pfoff/m0116_usb-/firmware/qmk/readme.md

# M0116 USB

m0116_usb

**[Deutsch](#deutsch) | [English](#english)**

## Deutsch

Drop-in-Ersatzplatine für den Apple M0116

* Keyboard-Maintainer: [elmo-space](https://github.com/elmo-space)
* Unterstützte Hardware: M0116 USB
* Verfügbarkeit der Hardware: [Das Projekt ist Open Source](https://github.com/elmo-space/m0116_usb)

Beispiel-Build für diese Tastatur (nachdem die Build-Umgebung eingerichtet ist):

    make kb_elmo/m0116_usb:default

Weitere Informationen: [Einrichtung der Build-Umgebung](https://docs.qmk.fm/#/getting_started_build_tools) und [Make-Anleitung](https://docs.qmk.fm/#/getting_started_make_guide). Ganz neu bei QMK? Am besten mit dem [Complete Newbs Guide](https://docs.qmk.fm/#/newbs) anfangen.

Hinweis: Diese QMK-Firmware gehört zum ursprünglichen ATmega32A-Design. Die
Wireless-TrackPoint-Revision (Branch `wireless-trackpoint`) verwendet einen
nice!nano v2 mit ZMK.

## English

Drop in replacement PCB for the Apple M0116

* Keyboard Maintainer: [elmo-space](https://github.com/elmo-space)
* Hardware Supported: M0116 USB
* Hardware Availability: [Project is open source](https://github.com/elmo-space/m0116_usb)

Make example for this keyboard (after setting up your build environment):

    make kb_elmo/m0116_usb:default

See the [build environment setup](https://docs.qmk.fm/#/getting_started_build_tools) and the [make instructions](https://docs.qmk.fm/#/getting_started_make_guide) for more information. Brand new to QMK? Start with our [Complete Newbs Guide](https://docs.qmk.fm/#/newbs).

Note: this QMK firmware belongs to the original ATmega32A design. The
wireless TrackPoint revision (branch `wireless-trackpoint`) uses a
nice!nano v2 running ZMK.
