pfoff/m0116_usb-/m0116_tkl.kicad_pcb

## KiCad design m0116_tkl.kicad_pcb (2026-10-25)

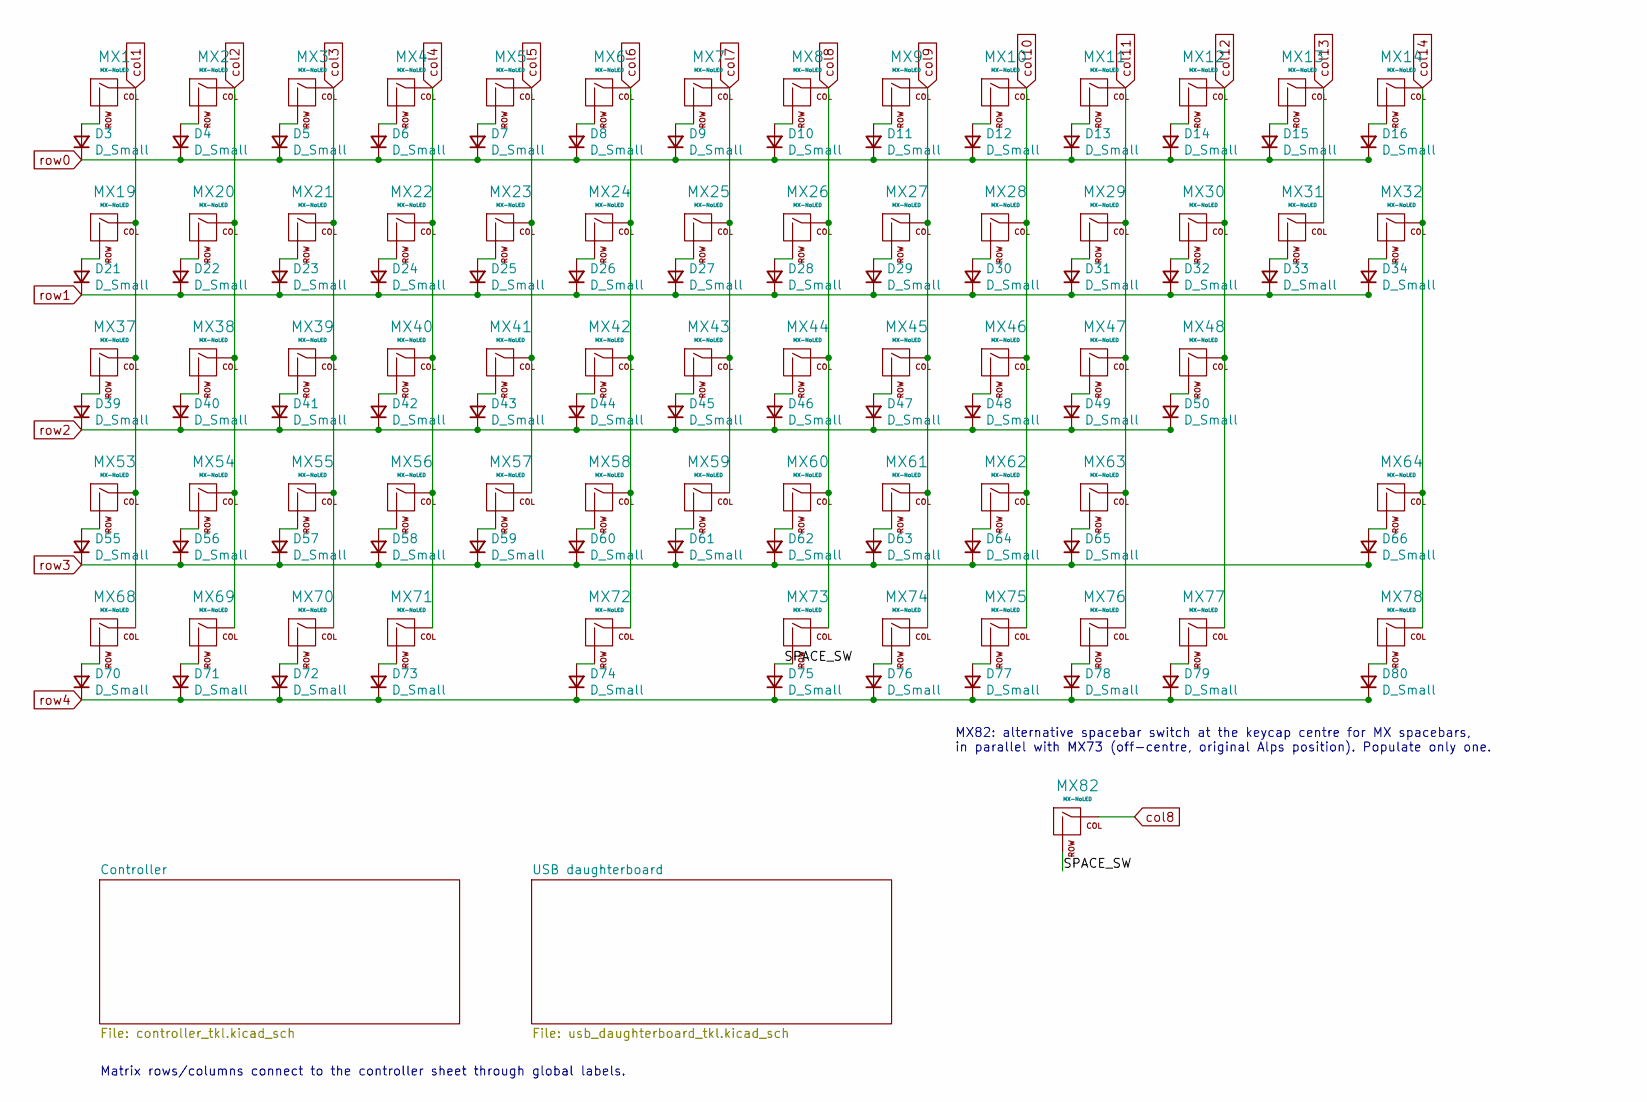
[picture p1: schematic m0116_tkl.kicad_sch]

Parts:
D3, D4, D5, D6, D7, D8, D9, D10, D11, D12, D13, D14, D15, D16, D21, D22, D23, D24, D25, D26, D27, D28, D29, D30, D31, D32, D33, D34, D39, D40, D41, D42, D43, D44, D45, D46, D47, D48, D49, D50, D55, D56, D57, D58, D59, D60, D61, D62, D63, D64, D65, D66, D70, D71, D72, D73, D74, D75, D76, D77, D78, D79, D80: D_Small; D_DO-35_SOD27_P7.62mm_Horizontal
MX1, MX2, MX3, MX4, MX5, MX6, MX7, MX8, MX9, MX10, MX11, MX12, MX13, MX14, MX19, MX20, MX21, MX22, MX23, MX24, MX25, MX26, MX27, MX28, MX29, MX30, MX31, MX32, MX37, MX38, MX39, MX40, MX41, MX42, MX43, MX44, MX45, MX46, MX47, MX48, MX53, MX54, MX55, MX56, MX57, MX58, MX59, MX60, MX61, MX62, MX63, MX64, MX68, MX69, MX70, MX71, MX72, MX73, MX74, MX75, MX76, MX77, MX78, MX82: MX-NoLED; MX-1U-NoLED

Connections:
/SPACE_SW: D75.2 (A), MX73.2 (ROW), MX82.2 (ROW)
unnamed: D3.2 (A), MX1.2 (ROW)
unnamed: D4.2 (A), MX2.2 (ROW)
unnamed: D5.2 (A), MX3.2 (ROW)
unnamed: D6.2 (A), MX4.2 (ROW)
unnamed: D7.2 (A), MX5.2 (ROW)
unnamed: D8.2 (A), MX6.2 (ROW)
unnamed: D9.2 (A), MX7.2 (ROW)
unnamed: D10.2 (A), MX8.2 (ROW)
unnamed: D11.2 (A), MX9.2 (ROW)
unnamed: D12.2 (A), MX10.2 (ROW)
unnamed: D13.2 (A), MX11.2 (ROW)
unnamed: D14.2 (A), MX12.2 (ROW)
unnamed: D15.2 (A), MX13.2 (ROW)
unnamed: D16.2 (A), MX14.2 (ROW)
unnamed: D21.2 (A), MX19.2 (ROW)
unnamed: D22.2 (A), MX20.2 (ROW)
unnamed: D23.2 (A), MX21.2 (ROW)
unnamed: D24.2 (A), MX22.2 (ROW)
unnamed: D25.2 (A), MX23.2 (ROW)
unnamed: D26.2 (A), MX24.2 (ROW)
unnamed: D27.2 (A), MX25.2 (ROW)
unnamed: D28.2 (A), MX26.2 (ROW)
unnamed: D29.2 (A), MX27.2 (ROW)
unnamed: D30.2 (A), MX28.2 (ROW)
unnamed: D31.2 (A), MX29.2 (ROW)
unnamed: D32.2 (A), MX30.2 (ROW)
unnamed: D33.2 (A), MX31.2 (ROW)
unnamed: D34.2 (A), MX32.2 (ROW)
unnamed: D39.2 (A), MX37.2 (ROW)
unnamed: D40.2 (A), MX38.2 (ROW)
unnamed: D41.2 (A), MX39.2 (ROW)
unnamed: D42.2 (A), MX40.2 (ROW)
unnamed: D43.2 (A), MX41.2 (ROW)
unnamed: D44.2 (A), MX42.2 (ROW)
unnamed: D45.2 (A), MX43.2 (ROW)
unnamed: D46.2 (A), MX44.2 (ROW)
unnamed: D47.2 (A), MX45.2 (ROW)
unnamed: D48.2 (A), MX46.2 (ROW)
unnamed: D49.2 (A), MX47.2 (ROW)
unnamed: D50.2 (A), MX48.2 (ROW)
unnamed: D55.2 (A), MX53.2 (ROW)
unnamed: D56.2 (A), MX54.2 (ROW)
unnamed: D57.2 (A), MX55.2 (ROW)
unnamed: D58.2 (A), MX56.2 (ROW)
unnamed: D59.2 (A), MX57.2 (ROW)
unnamed: D60.2 (A), MX58.2 (ROW)
unnamed: D61.2 (A), MX59.2 (ROW)
unnamed: D62.2 (A), MX60.2 (ROW)
unnamed: D63.2 (A), MX61.2 (ROW)
unnamed: D64.2 (A), MX62.2 (ROW)
unnamed: D65.2 (A), MX63.2 (ROW)
unnamed: D66.2 (A), MX64.2 (ROW)
unnamed: D70.2 (A), MX68.2 (ROW)
unnamed: D71.2 (A), MX69.2 (ROW)
unnamed: D72.2 (A), MX70.2 (ROW)
unnamed: D73.2 (A), MX71.2 (ROW)
unnamed: D74.2 (A), MX72.2 (ROW)
unnamed: D76.2 (A), MX74.2 (ROW)
unnamed: D77.2 (A), MX75.2 (ROW)
unnamed: D78.2 (A), MX76.2 (ROW)
unnamed: D79.2 (A), MX77.2 (ROW)
unnamed: D80.2 (A), MX78.2 (ROW)
col1: MX1.1 (COL), MX19.1 (COL), MX37.1 (COL), MX53.1 (COL), MX68.1 (COL); also elsewhere on the board
col2: MX2.1 (COL), MX20.1 (COL), MX38.1 (COL), MX54.1 (COL), MX69.1 (COL); also elsewhere on the board
col3: MX3.1 (COL), MX21.1 (COL), MX39.1 (COL), MX55.1 (COL), MX70.1 (COL); also elsewhere on the board
col4: MX4.1 (COL), MX22.1 (COL), MX40.1 (COL), MX56.1 (COL), MX71.1 (COL); also elsewhere on the board
col5: MX5.1 (COL), MX23.1 (COL), MX41.1 (COL), MX57.1 (COL); also elsewhere on the board
col6: MX6.1 (COL), MX24.1 (COL), MX42.1 (COL), MX58.1 (COL), MX72.1 (COL); also elsewhere on the board
col7: MX7.1 (COL), MX25.1 (COL), MX43.1 (COL), MX59.1 (COL); also elsewhere on the board
col8: MX8.1 (COL), MX26.1 (COL), MX44.1 (COL), MX60.1 (COL), MX73.1 (COL), MX82.1 (COL); also elsewhere on the board
col9: MX9.1 (COL), MX27.1 (COL), MX45.1 (COL), MX61.1 (COL), MX74.1 (COL); also elsewhere on the board
col10: MX10.1 (COL), MX28.1 (COL), MX46.1 (COL), MX62.1 (COL), MX75.1 (COL); also elsewhere on the board
col11: MX11.1 (COL), MX29.1 (COL), MX47.1 (COL), MX63.1 (COL), MX76.1 (COL); also elsewhere on the board
col12: MX12.1 (COL), MX30.1 (COL), MX48.1 (COL), MX77.1 (COL); also elsewhere on the board
col13: MX13.1 (COL), MX31.1 (COL); also elsewhere on the board
col14: MX14.1 (COL), MX32.1 (COL), MX64.1 (COL), MX78.1 (COL); also elsewhere on the board
row0: D3.1 (K), D4.1 (K), D5.1 (K), D6.1 (K), D7.1 (K), D8.1 (K), D9.1 (K), D10.1 (K), D11.1 (K), D12.1 (K), D13.1 (K), D14.1 (K), D15.1 (K), D16.1 (K); also elsewhere on the board
row1: D21.1 (K), D22.1 (K), D23.1 (K), D24.1 (K), D25.1 (K), D26.1 (K), D27.1 (K), D28.1 (K), D29.1 (K), D30.1 (K), D31.1 (K), D32.1 (K), D33.1 (K), D34.1 (K); also elsewhere on the board
row2: D39.1 (K), D40.1 (K), D41.1 (K), D42.1 (K), D43.1 (K), D44.1 (K), D45.1 (K), D46.1 (K), D47.1 (K), D48.1 (K), D49.1 (K), D50.1 (K); also elsewhere on the board
row3: D55.1 (K), D56.1 (K), D57.1 (K), D58.1 (K), D59.1 (K), D60.1 (K), D61.1 (K), D62.1 (K), D63.1 (K), D64.1 (K), D65.1 (K), D66.1 (K); also elsewhere on the board
row4: D70.1 (K), D71.1 (K), D72.1 (K), D73.1 (K), D74.1 (K), D75.1 (K), D76.1 (K), D77.1 (K), D78.1 (K), D79.1 (K), D80.1 (K); also elsewhere on the board

Notes on the sheet:
Matrix rows/columns connect to the controller sheet through global labels.
MX82: alternative spacebar switch at the keycap centre for MX spacebars, in parallel with MX73 (off-centre, original Alps position). Populate only one.

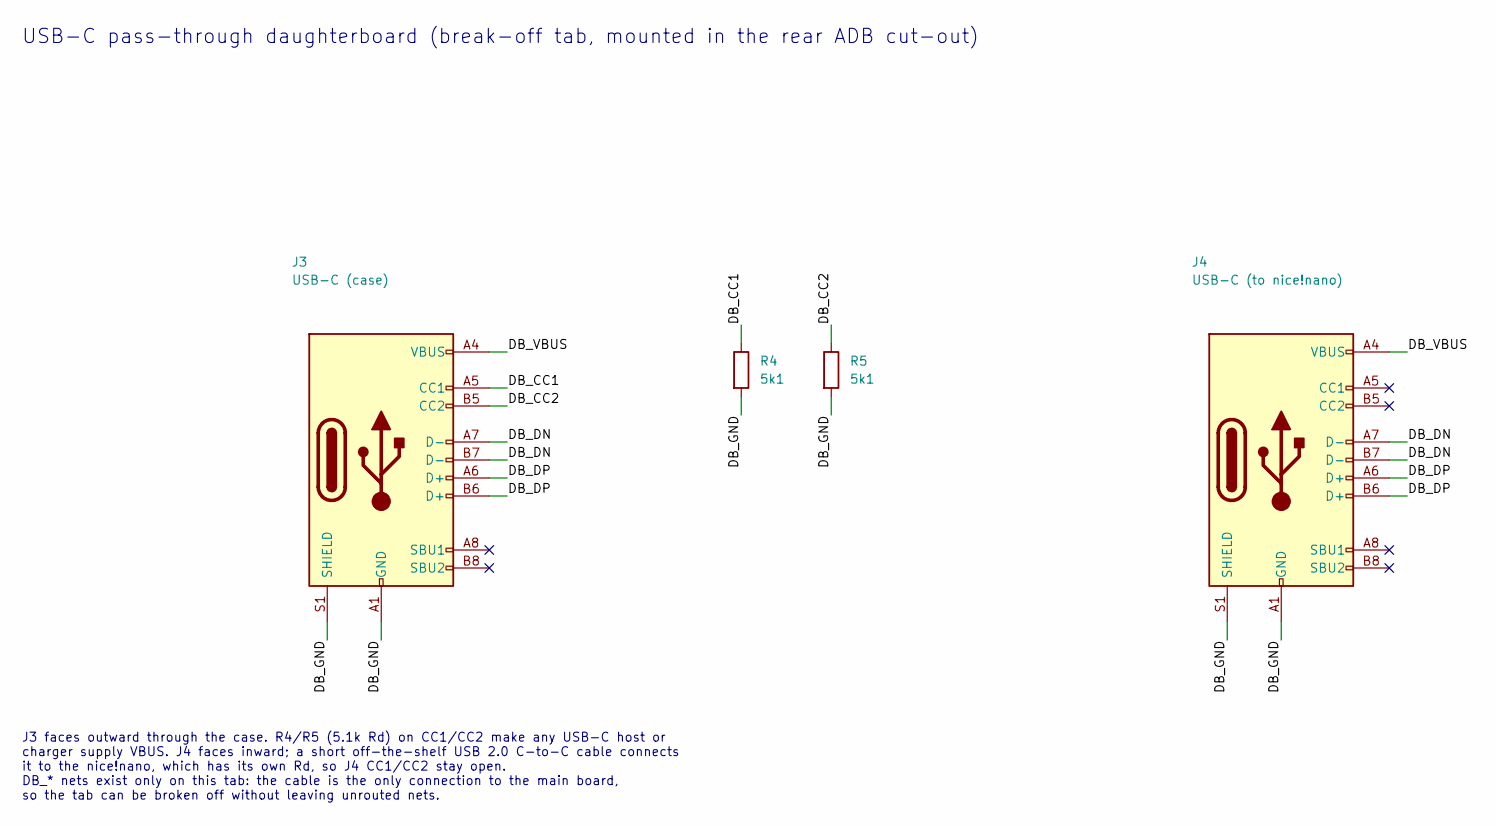
[picture p2: schematic usb_daughterboard_tkl.kicad_sch, M0116 wireless TrackPoint - USB-C daughterboard]

Parts:
J3: USB-C (case); USB_C_Receptacle_GCT_USB4085
J4: USB-C (to nice!nano); USB_C_Receptacle_GCT_USB4085
R4, R5: 5k1; R_Axial_DIN0207_L6.3mm_D2.5mm_P2.54mm_Vertical

Connections:
/USB daughterboard/DB_CC1: J3.A5 (CC1), R4.1
/USB daughterboard/DB_CC2: J3.B5 (CC2), R5.1
/USB daughterboard/DB_DN: J3.A7 (D-), J3.B7 (D-), J4.A7 (D-), J4.B7 (D-)
/USB daughterboard/DB_DP: J3.A6 (D+), J3.B6 (D+), J4.A6 (D+), J4.B6 (D+)
/USB daughterboard/DB_GND: J3.A1 (GND), J3.A12 (GND), J3.B1 (GND), J3.B12 (GND), J3.S1 (SHIELD), J4.A1 (GND), J4.A12 (GND), J4.B1 (GND), J4.B12 (GND), J4.S1 (SHIELD), R4.2, R5.2
/USB daughterboard/DB_VBUS: J3.A4 (VBUS), J3.A9 (VBUS), J3.B4 (VBUS), J3.B9 (VBUS), J4.A4 (VBUS), J4.A9 (VBUS), J4.B4 (VBUS), J4.B9 (VBUS)

Notes on the sheet:
USB-C pass-through daughterboard (break-off tab, mounted in the rear ADB cut-out)
J3 faces outward through the case. R4/R5 (5.1k Rd) on CC1/CC2 make any USB-C host or charger supply VBUS. J4 faces inward; a short off-the-shelf USB 2.0 C-to-C cable connects it to the nice!nano, which has its own Rd, so J4 CC1/CC2 stay open. DB_* nets exist only on this tab: the cable is the only 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

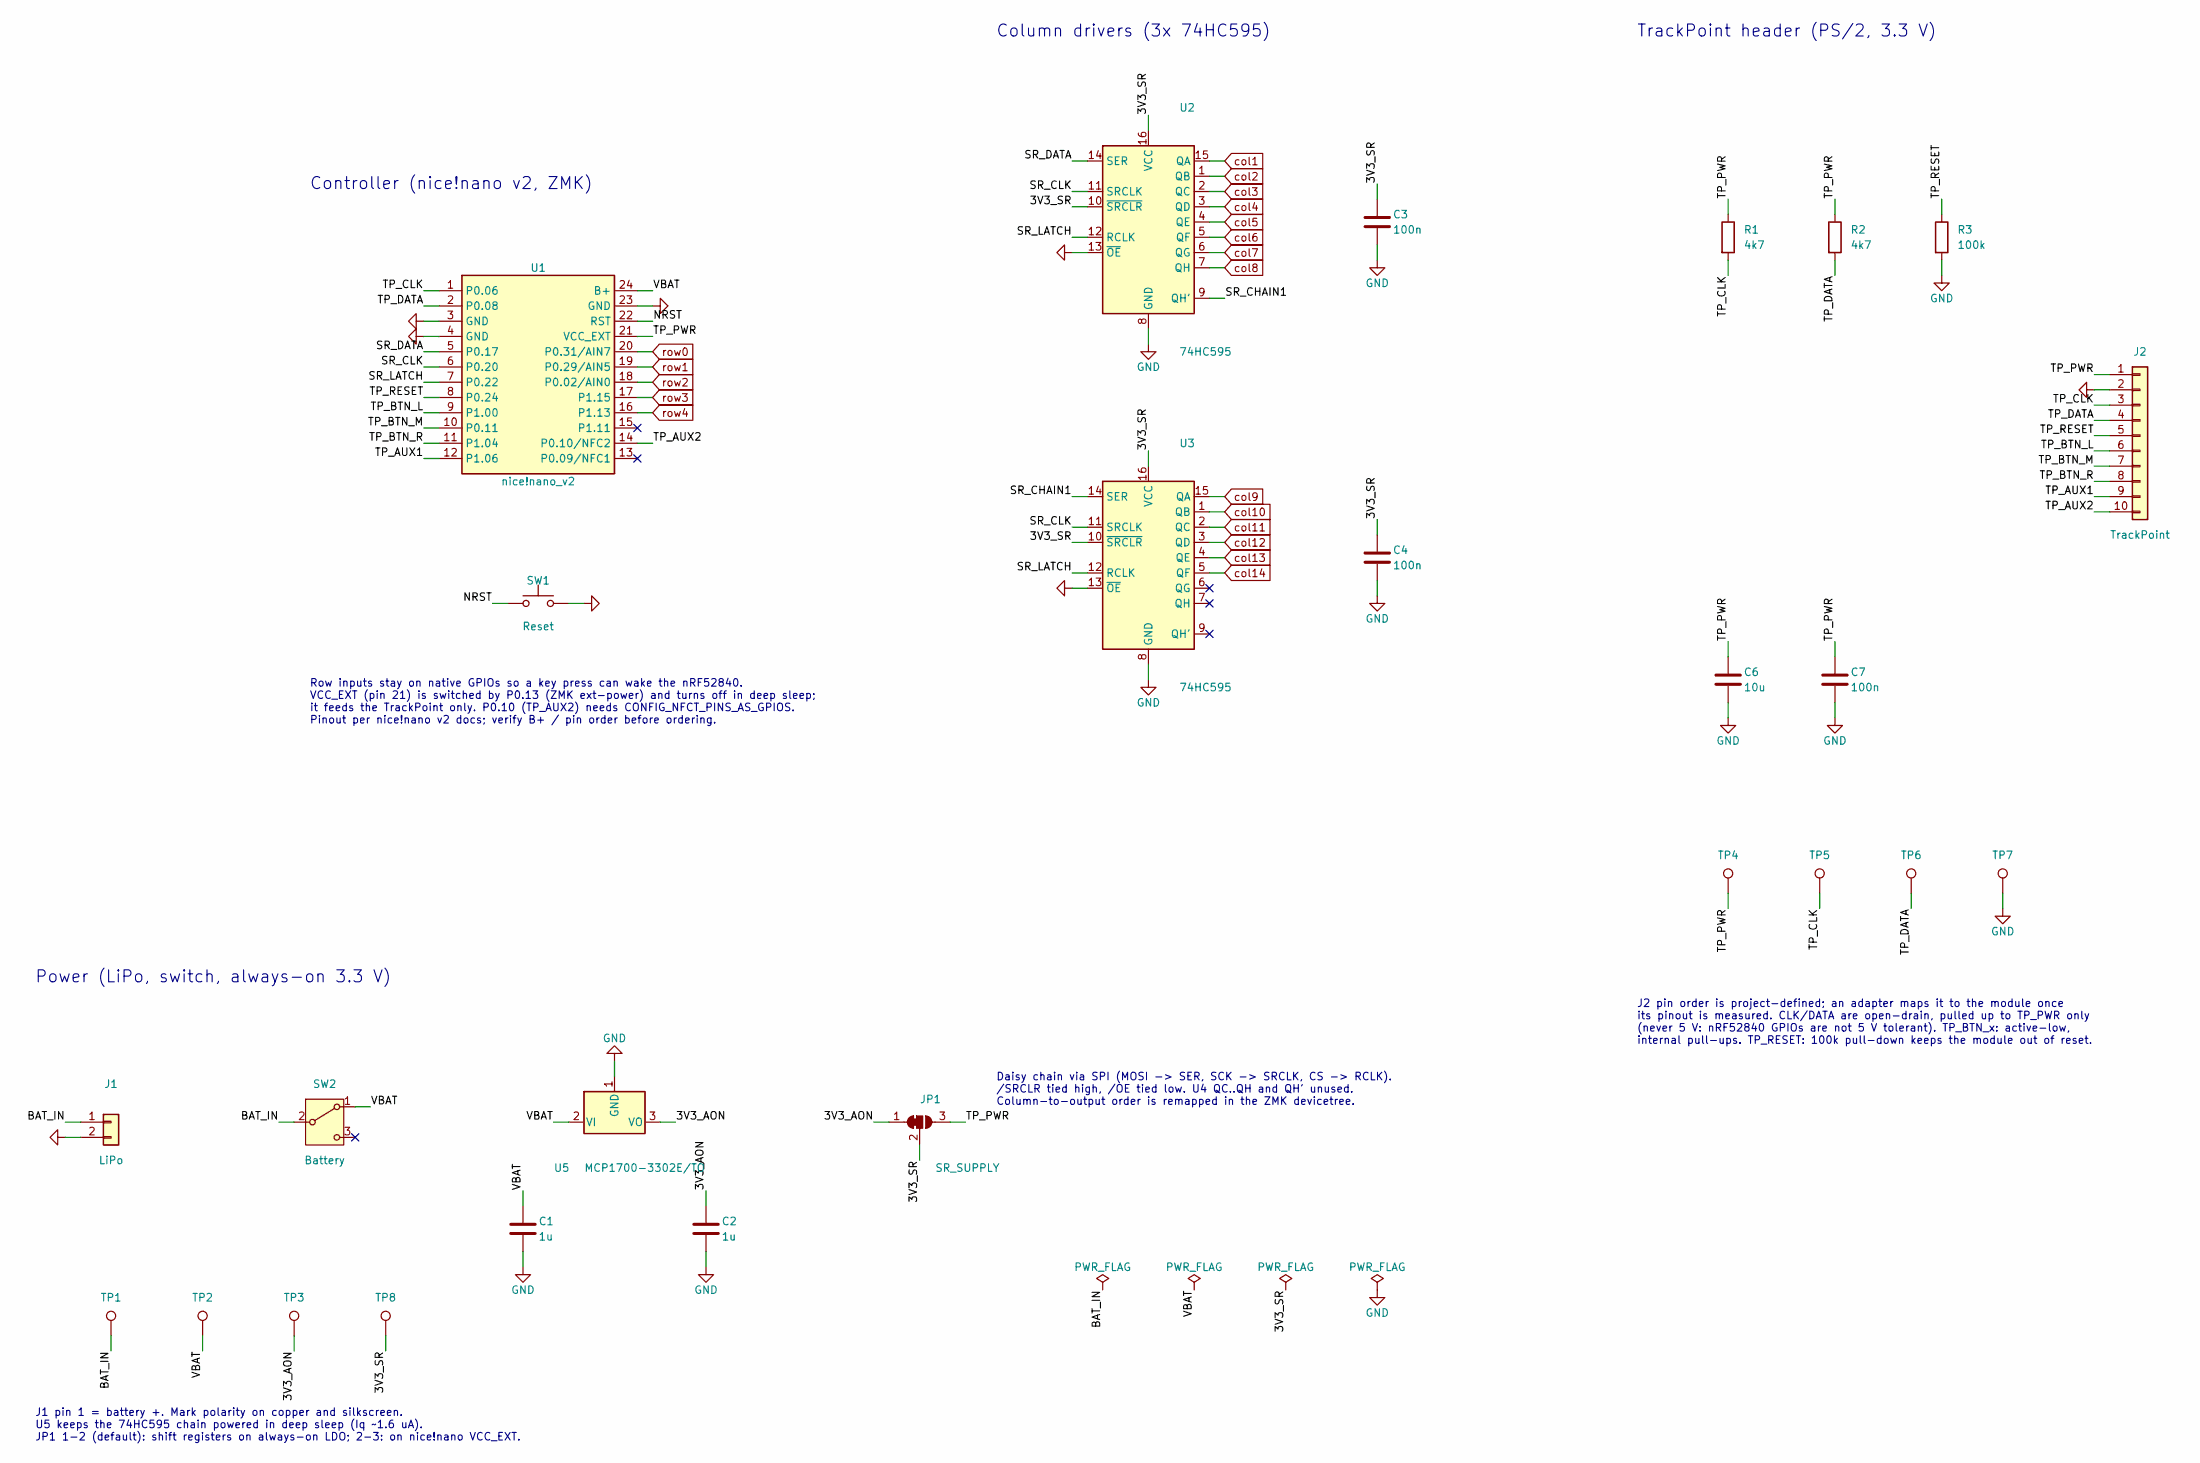
[picture p3: schematic controller_tkl.kicad_sch, M0116 wireless TrackPoint - controller]

Parts:
C1, C2: 1u; C_Disc_D3.0mm_W2.0mm_P2.50mm
C3, C4, C7: 100n; C_Disc_D3.0mm_W2.0mm_P2.50mm
C6: 10u; C_Disc_D5.0mm_W2.5mm_P5.00mm
J1: LiPo; JST_PH_S2B-PH-K_1x02_P2.00mm_Horizontal
J2: TrackPoint; PinHeader_1x10_P2.54mm_Vertical
JP1: SR_SUPPLY; SolderJumper-3_P1.3mm_Bridged12_RoundedPad1.0x1.5mm_NumberL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
R1, R2: 4k7; R_Axial_DIN0207_L6.3mm_D2.5mm_P10.16mm_Horizontal
R3: 100k; R_Axial_DIN0207_L6.3mm_D2.5mm_P10.16mm_Horizontal
SW1: Reset; SW_PUSH_6mm
SW2: Battery; SW_Slide_SPDT_Angled_CK_OS102011MA1Q
TP1: BAT_IN; TestPoint_THTPad_D1.5mm_Drill0.7mm
TP2: VBAT; TestPoint_THTPad_D1.5mm_Drill0.7mm
TP3: 3V3_AON; TestPoint_THTPad_D1.5mm_Drill0.7mm
TP4: TP_PWR; TestPoint_THTPad_D1.5mm_Drill0.7mm
TP5: TP_CLK; TestPoint_THTPad_D1.5mm_Drill0.7mm
TP6: TP_DATA; TestPoint_THTPad_D1.5mm_Drill0.7mm
TP7: GND; TestPoint_THTPad_D1.5mm_Drill0.7mm
TP8: 3V3_SR; TestPoint_THTPad_D1.5mm_Drill0.7mm
U1: nice!nano_v2; DIP-24_W15.24mm_Socket
U2, U3: 74HC595; DIP-16_W7.62mm_Socket
U5: MCP1700-3302E/TO; TO-92_Inline

Connections:
/Controller/3V3_AON: C2.1, JP1.1 (A), TP3.1, U5.3 (VO)
/Controller/3V3_SR: C3.1, C4.1, JP1.2 (C), TP8.1, U2.10 (~SRCLR), U2.16 (VCC), U3.10 (~SRCLR), U3.16 (VCC)
/Controller/BAT_IN: J1.1, SW2.2 (B), TP1.1
/Controller/NRST: SW1.1, U1.22 (RST)
/Controller/SR_CHAIN1: U2.9 (QH'), U3.14 (SER)
/Controller/SR_CLK: U1.6 (P0.20), U2.11 (SRCLK), U3.11 (SRCLK)
/Controller/SR_DATA: U1.5 (P0.17), U2.14 (SER)
/Controller/SR_LATCH: U1.7 (P0.22), U2.12 (RCLK), U3.12 (RCLK)
/Controller/TP_AUX1: J2.9, U1.12 (P1.06)
/Controller/TP_AUX2: J2.10, U1.14 (P0.10/NFC2)
/Controller/TP_BTN_L: J2.6, U1.9 (P1.00)
/Controller/TP_BTN_M: J2.7, U1.10 (P0.11)
/Controller/TP_BTN_R: J2.8, U1.11 (P1.04)
/Controller/TP_CLK: J2.3, R1.2, TP5.1, U1.1 (P0.06)
/Controller/TP_DATA: J2.4, R2.2, TP6.1, U1.2 (P0.08)
/Controller/TP_PWR: C6.1, C7.1, J2.1, JP1.3 (B), R1.1, R2.1, TP4.1, U1.21 (VCC_EXT)
/Controller/TP_RESET: J2.5, R3.1, U1.8 (P0.24)
/Controller/VBAT: C1.1, SW2.1 (A), TP2.1, U1.24 (B+), U5.2 (VI)
GND: C1.2, C2.2, C3.2, C4.2, C6.2, C7.2, J1.2, J2.2, R3.2, SW1.2, TP7.1, U1.3 (GND), U1.4 (GND), U1.23 (GND), U2.8 (GND), U2.13 (~OE), U3.8 (GND), U3.13 (~OE), U5.1 (GND)
col1: U2.15 (QA); also elsewhere on the board
col2: U2.1 (QB); also elsewhere on the board
col3: U2.2 (QC); also elsewhere on the board
col4: U2.3 (QD); also elsewhere on the board
col5: U2.4 (QE); also elsewhere on the board
col6: U2.5 (QF); also elsewhere on the board
col7: U2.6 (QG); also elsewhere on the board
col8: U2.7 (QH); also elsewhere on the board
col9: U3.15 (QA); also elsewhere on the board
col10: U3.1 (QB); also elsewhere on the board
col11: U3.2 (QC); also elsewhere on the board
col12: U3.3 (QD); also elsewhere on the board
col13: U3.4 (QE); also elsewhere on the board
col14: U3.5 (QF); also elsewhere on the board
row0: U1.20 (P0.31/AIN7); also elsewhere on the board
row1: U1.19 (P0.29/AIN5); also elsewhere on the board
row2: U1.18 (P0.02/AIN0); also elsewhere on the board
row3: U1.17 (P1.15); also elsewhere on the board
row4: U1.16 (P1.13); also elsewhere on the board

Notes on the sheet:
J1 pin 1 = battery +. Mark polarity on copper and silkscreen. U5 keeps the 74HC595 chain powered in deep sleep (Iq ~1.6 uA). JP1 1-2 (default): shift registers on always-on LDO; 2-3: on nice!nano VCC_EXT.
Row inputs stay on native GPIOs so a key press can wake the nRF52840. VCC_EXT (pin 21) is switched by P0.13 (ZMK ext-power) and turns off in deep sleep; it feeds the TrackPoint only. P0.10 (TP_AUX2) needs CONFIG_NFCT_PINS_AS_GPIOS. Pinout per nice!nano v2 docs; verify B+ / pin order before ordering.
Column drivers (3x 74HC595)
Controller (nice!nano v2, ZMK)
Power (LiPo, switch, always-on 3.3 V)
Daisy chain via SPI (MOSI -> SER, SCK -> SRCLK, CS -> RCLK). /SRCLR tied high, /OE tied low. U4 QC..QH and QH' unused. Column-to-output order is remapped in the ZMK devicetree.
TrackPoint header (PS/2, 3.3 V)
J2 pin order is project-defined; an adapter maps it to the module once its pinout is measured. CLK/DATA are open-drain, pulled up to TP_PWR only (never 5 V: nRF52840 GPIOs are not 5 V tolerant). TP_BTN_x: active-low, internal pull-ups. TP_RESET: 100k pull-down keeps the module out of reset.

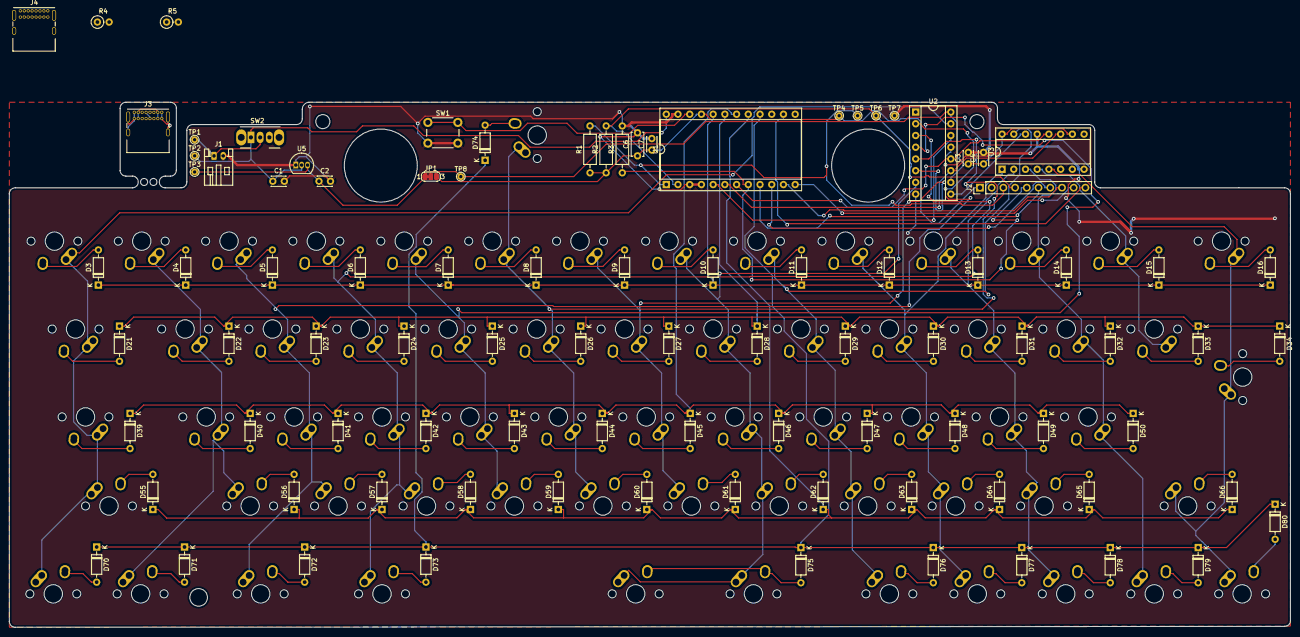
[picture p4: board m0116_tkl.kicad_pcb from above]

Board: 2 copper layers, 277.7 x 113.8 mm, 157 parts (0 on the bottom side), 107 nets.
