pfoff/m0116_usb-/(commit log)

2026-10-23 Convert KiCad 5 project to KiCad 7 format
    Pure format migration, no circuit or layout changes:
    - m0116_usb.kicad_pcb: re-saved with KiCad 7.0.11 (186 footprints,
    843 segments, 4 vias, 126 nets, 3 zones preserved). Legacy zone fill
    strategy converted on a best-effort basis; zones need a refill
    before fabrication.
    - m0116_usb.sch -> m0116_usb.kicad_sch, m0116_usb.pro ->
    m0116_usb.kicad_pro (net classes and design rules migrated).
    - Symbols that differ from the KiCad 7 libraries (ATmega32A-PU, CP1,
    USB_B_Mini) were rescued into m0116_usb-rescue.kicad_sym.
    - Removed legacy files (.sch, .pro, -cache.lib, -bak) and the local
    fp-info-cache; added .gitignore for KiCad per-user state.
    S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
2026-10-23 Replace ATmega/V-USB controller with nice!nano v2 schematic
    Schematic-only change for Revision A of the wireless TrackPoint mod.
    The PCB has not been updated yet.
    Root sheet: the 5x18 matrix (81 switches, 81 diodes) is unchanged and
    now connects to a new "Controller" sub-sheet through the existing
    global labels row0-row4 / col1-col18. Removed the ATmega32A, V-USB
    circuit, crystal, ISP header, mini-USB, polyfuse and boot button.
    controller.kicad_sch:
    - nice!nano v2 (socketed, Pro Micro footprint) with reset button;
    rows on native GPIOs for key-press wake-up
    - 3x 74HC595 daisy-chained over SPI drive col1-col18, 100n each
    - LiPo (JST PH) -> slide switch -> B+
    - MCP1700 always-on LDO for the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
2026-10-23 Add USB-C pass-through daughterboard schematic
    The nice!nano USB-C port is not reachable from outside the case. Keep
    the original break-off daughterboard concept (tab glued into the rear
    ADB cut-out) and turn it into a USB-C pass-through:
    - J3: GCT USB4085 THT USB-C receptacle facing outward, 5.1k Rd on
    CC1/CC2 (R4/R5) so USB-C hosts and chargers supply VBUS
    - J4: second USB4085 facing inward; a short off-the-shelf USB 2.0
    C-to-C cable connects it to the nice!nano (CC left open, the
    nice!nano has its own Rd)
    - DB_* nets live only on the tab, so breaking it off leaves no
    unrouted connections to the main board
    ERC: 0 errors, 0 warnings.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
2026-10-23 Add wireless TrackPoint design document
    Architecture, Revision A pin assignment, design decisions and open
    points for the nice!nano / ZMK / TrackPoint mod.
2026-10-23 Add Makefile and KiCad 7 helper scripts
    - tools/update_pcb.py: headless "Update PCB from Schematic". Matches
    footprints to symbols by sheet path + UUID, removes orphaned
    footprints, loads and links new ones, places them from
    tools/placement.json (only on creation), moves tracks/zones to
    renamed nets, removes tracks of vanished nets and dangling stubs,
    adds footprint-relative keepouts and refills zones. Refuses to run
    while Pcbnew has the board open. Works around a KiCad 7 SWIG bug
    where footprint loading breaks after removed items are collected.
    - tools/check_pcb.py: per-net routing report (pads grouped into
    islands through tracks, vias and zone fills)
    - tools/check_netlist.p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
2026-10-23 Update PCB from schematic for the nice!nano controller
    Generated with `make pcb-update`:
    - removed the 20 footprints of the ATmega/V-USB controller
    - added 32 footprints linked to the new symbols; 29 placed in the rear
    strip behind the number row, J4/R4/R5 parked above the board until
    the daughterboard tab is resized
    - removed 377 track segments of vanished nets and 118 dangling stubs
    - matrix tracks moved to the KiCad 7 net names (179 items)
    - keepout (no tracks, vias, pour) under the nice!nano antenna
    - zones refilled
    Matrix footprints and pads are unchanged; all matrix nets remain fully
    routed. 48 nets with new controller connections are still unrouted.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
2026-10-23 Document the wireless TrackPoint revision in the README
2026-10-25 Add MX/Alps hybrid footprints, TKL variant and Freerouting workflow
    Snapshot, routing still in progress.
    - switch footprints changed to MX_Alps_Hybrid:MX-1U-NoLED, optional
    centred MX spacebar switch MX82
    - m0116_tkl: board without keypad, generated by make tkl-sch / tkl-pcb,
    right edge copies the original contour; partially autorouted
    (open: col2, GND islands near U2/U3, USB daughterboard by hand)
    - tools/export_matrix_dsn.py, tools/import_ses.py: Specctra DSN/SES
    round trip for Freerouting (make dsn, make dsn-continue)
    - full board: old matrix tracks still cross the MX centre holes until
    it is rerouted
2026-10-25 Route TKL board, add GND stitching, TODO and bilingual READMEs
    - m0116_tkl.kicad_pcb: Freerouting result imported; open are only
    GND at J2 pin 2, col2 at U2 pin 1 and the USB daughterboard (tab
    outline still to be sized)
    - export_matrix_dsn.py: --continue routes GND as tracks with signal
    width, USB daughterboard nets left out, outline shrunk / holes
    enlarged for KiCad's 0.5 mm edge clearance
    - tools/stitch_gnd.py: vias from GND pour islands to the main pour
    - TODO.md: remaining steps for KiCad beginners
    - README.md and firmware/qmk/readme.md in German and English
