pfoff/m0116_usb-/(notices)

Notices in the files:
controller.kicad_sch:
Based on m0116_usb by elmo (CC BY-NC-SA 4.0)
README.md:
CC BY-NC-SA 4.0
